garrettsworkshop/RAM2E/Documentation/Timing.png

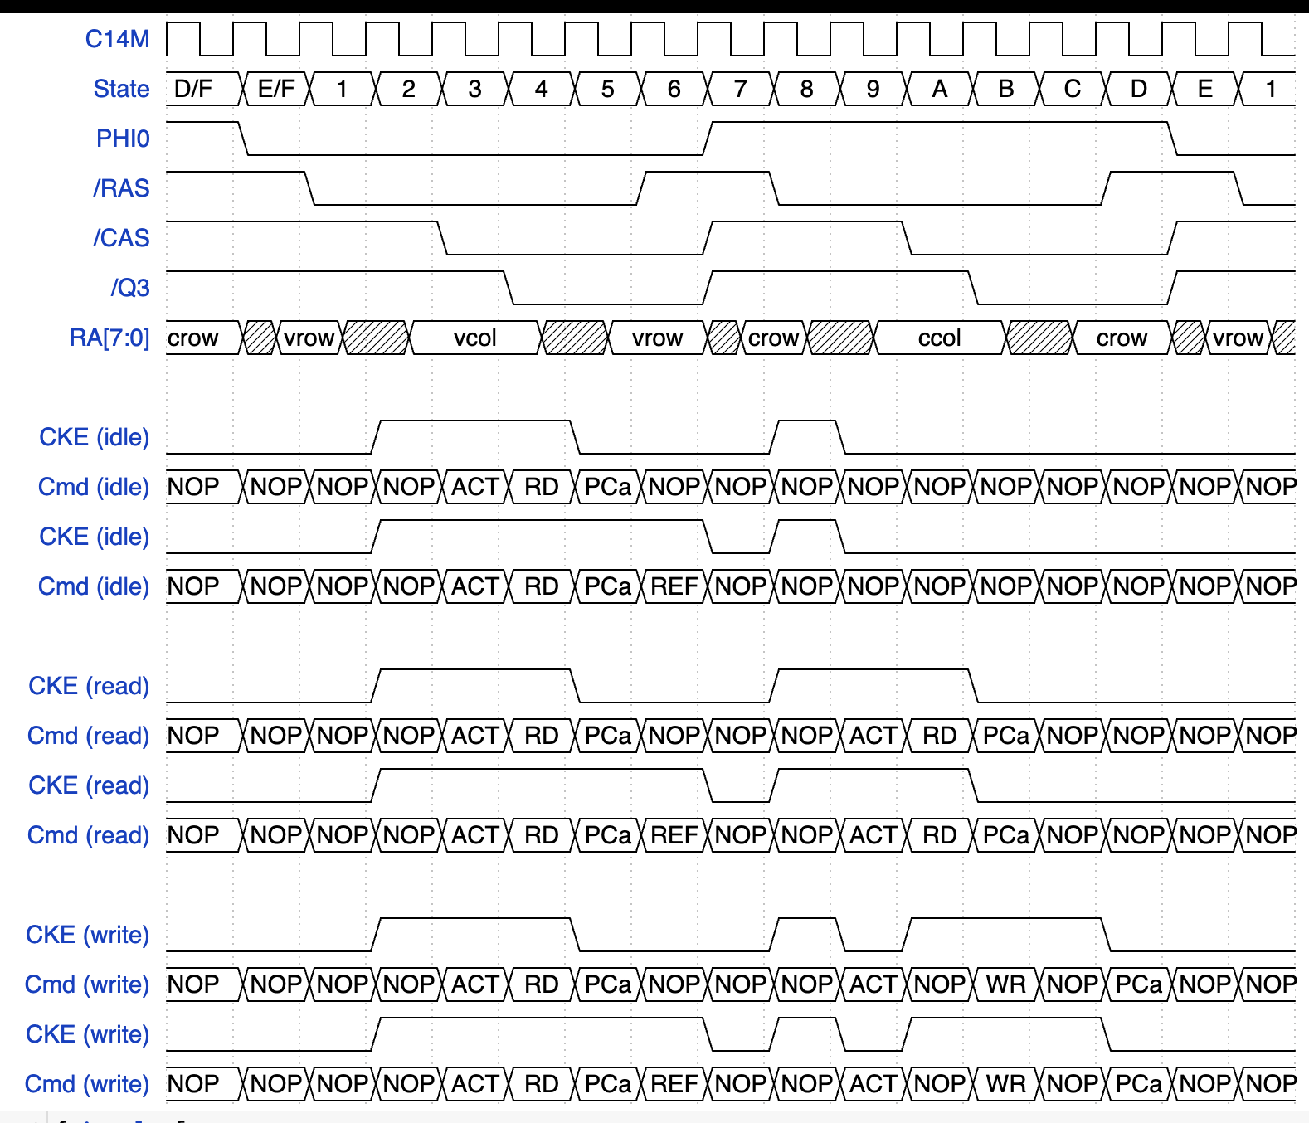
Documentation/Timing.png
