garrettsworkshop/RAM2E/Hardware/LCMXO2/Documentation/RAM2E.4203C.LCMXO2-Schematic.pdf

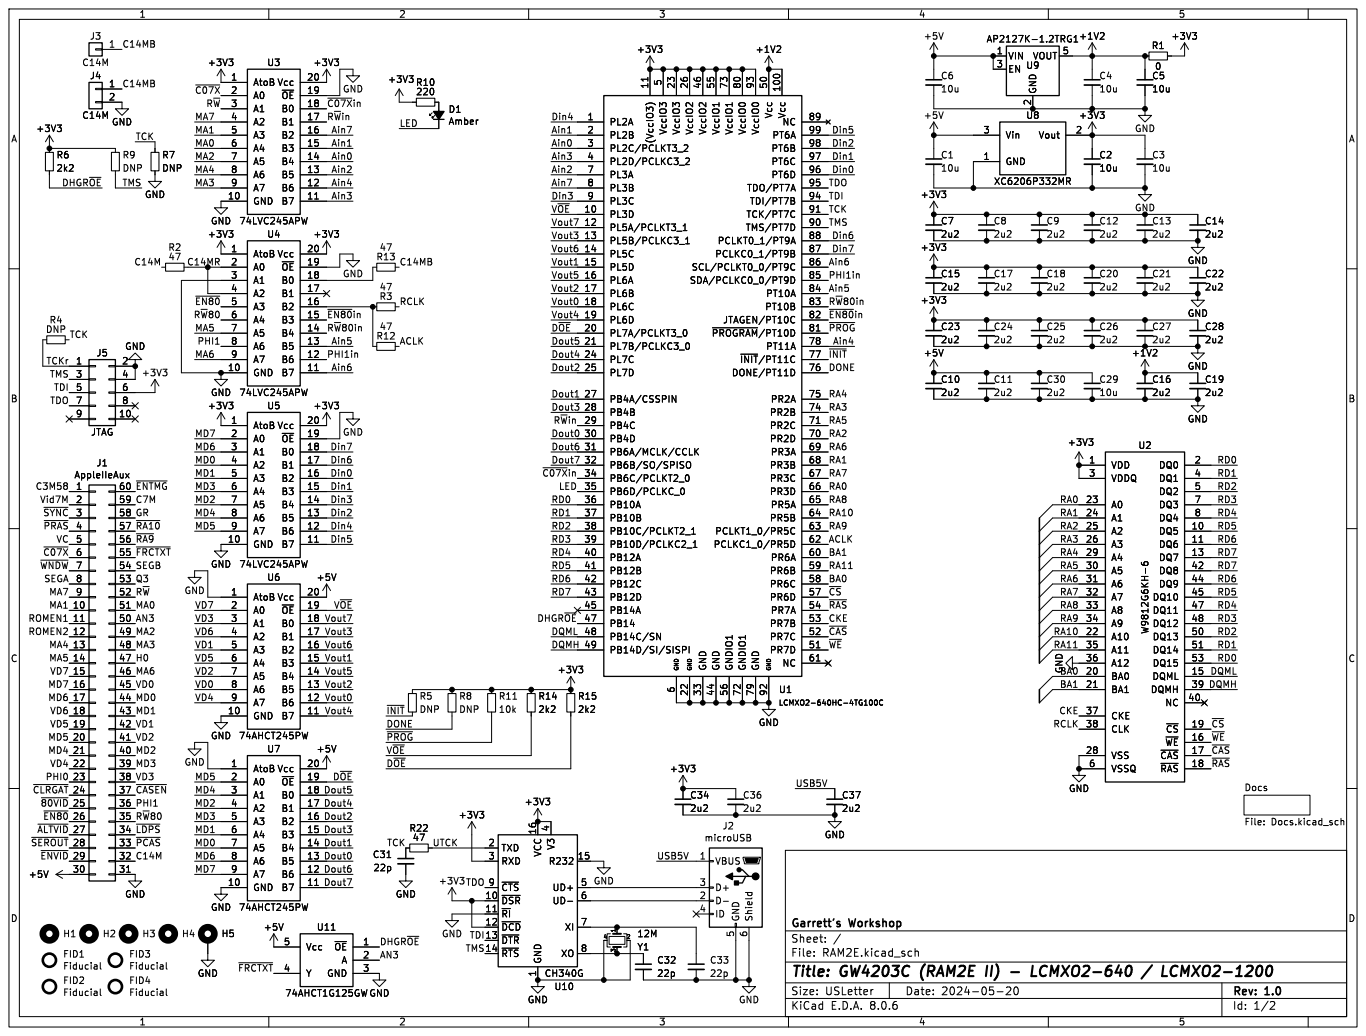
[picture p12: page 1]

2 EN 3 VOUT 5 U8 XC6206P332MR GND 1 Vout 2 Vin 3 C7

5 Vcc 50 PR7D 51 PR7C 52 PR7B 53 PR7A 54 VccIO1 55 GNDIO1 56 PR6D 57 PR6C 58 PR6B 59 GND 6 PR6A 60 NC 61 PCLKC1_0/PR5D 62 PCLKT1_0/PR5C 63 PR5B 64 PR5A 65 PR3D 66 PR3C 67 PR3B 68 PR3A 69 PL3A 7 PR2D 70 PR2C 71 GNDIO1 72 VccIO1 73 PR2B 74 PR2A 75 DONE/PT11D 76 ~{INIT}/PT11C 77 PT11A 78 GND 79 PL3B 8 VccIO0 80

4 UD+ 5 UD- 6 XI 7 XO 8 ~{CTS} 9 GND GND

1 ~{DSR} 10 ~{RI} 11 ~{DCD} 12 ~{DTR} 13 ~{RTS} 14 R232 VCC 15 16 TXD 2 RXD 3 V3

4 UD+ 5 UD- 6 XI 7 XO 8 ~{CTS} 9 U10 CH340G

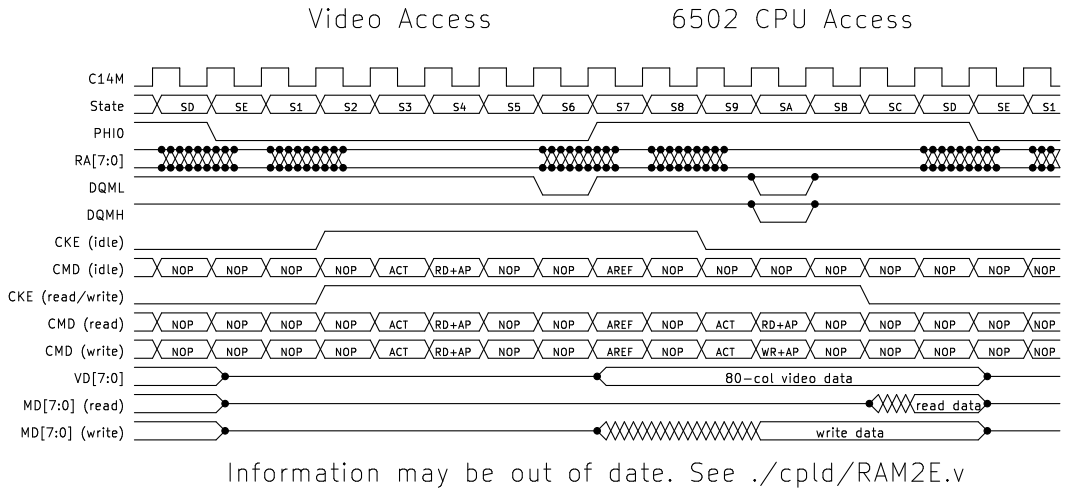
[picture p13: page 2]

ACT NOP NOP NOP

File: Docs.kicad_sch Sheet: /Docs/ Garrett's Workshop
