garrettsworkshop/RAM2E/Hardware/MAX/Documentation/RAM2E.4203C.MAX-Schematic.pdf

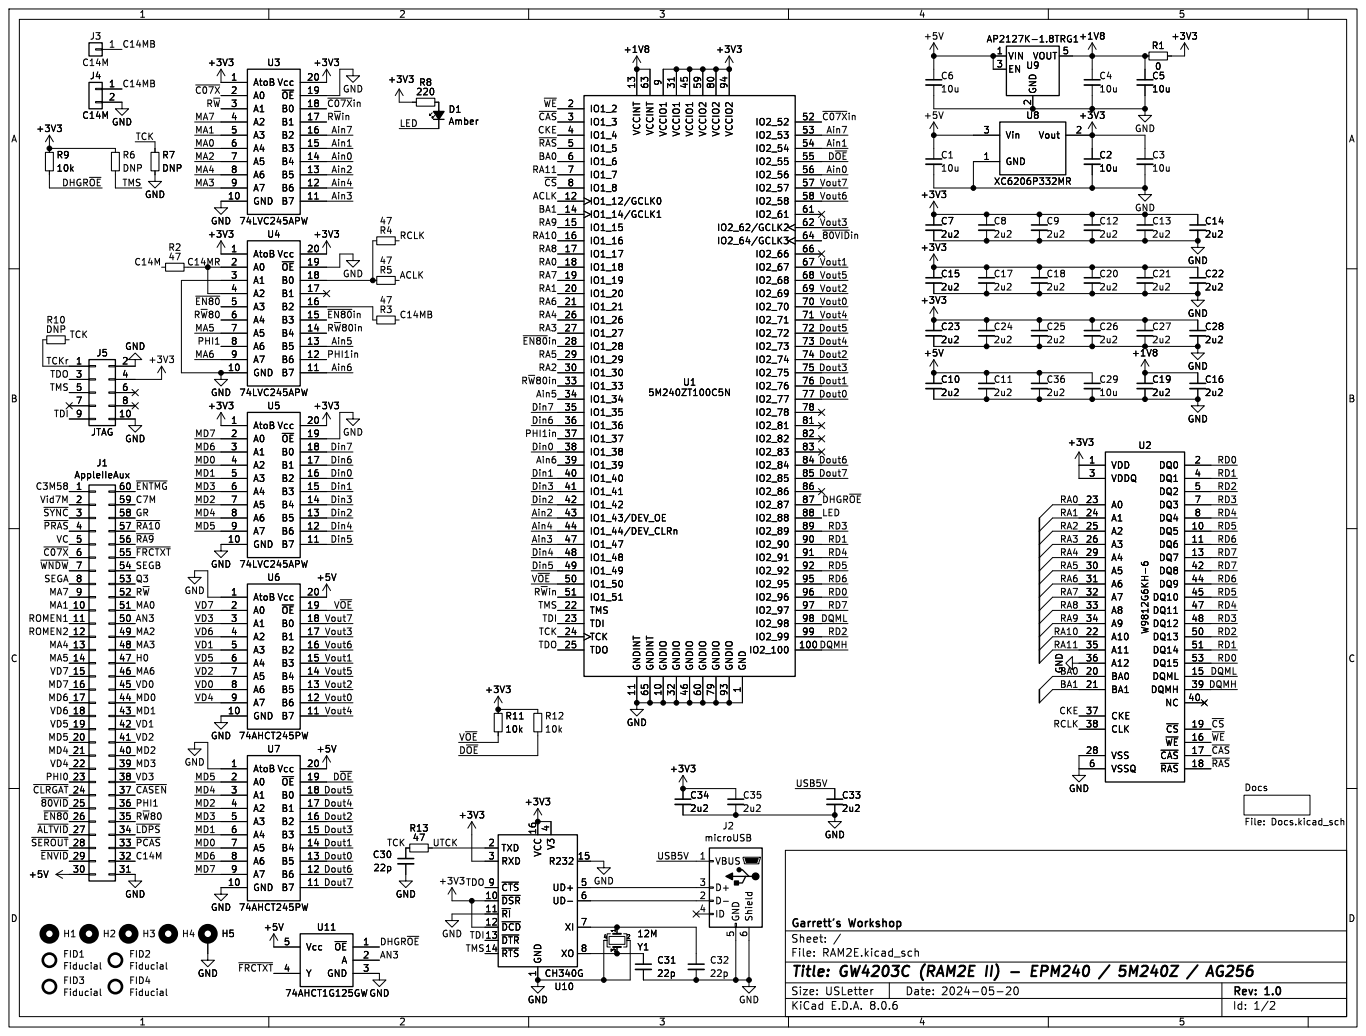
[picture p14: page 1]

2 EN 3 VOUT 5 U8 XC6206P332MR GND 1 Vout 2 Vin 3 +3V3 C22

V~{OE} TMS Din5 ~{EN80}in PHI1in Din5 V~{OE}

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

4 UD+ 5 UD- 6 XI 7 XO 8 ~{CTS} 9 U10 CH340G

4 UD+ 5 UD- 6 XI 7 XO 8 ~{CTS} 9 GND


ACT ACT NOP CKE (idle) DQML RA[7:0] DQMH

File: Docs.kicad_sch Sheet: /Docs/ Garrett's Workshop
