garrettsworkshop/RAM2E/Hardware/LCMXO2/Documentation/RAM2E.4203C.LCMXO2-Placement.pdf

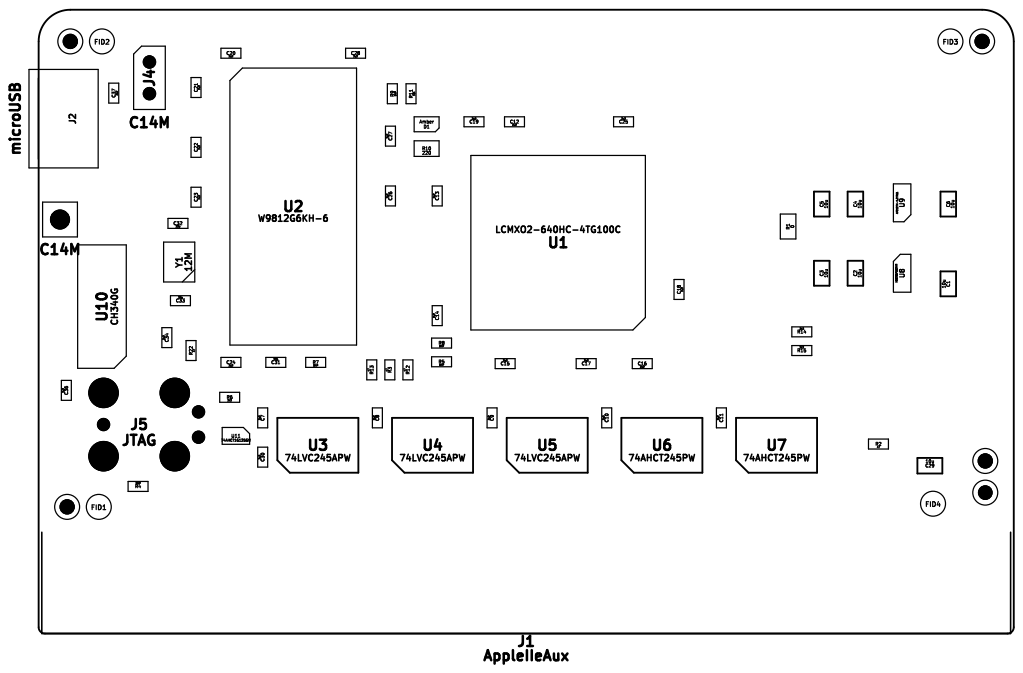
[picture p15: page 1]
