garrettsworkshop/RAM2E/Hardware/MAX/Documentation/RAM2E.4203C.MAX-Placement.pdf

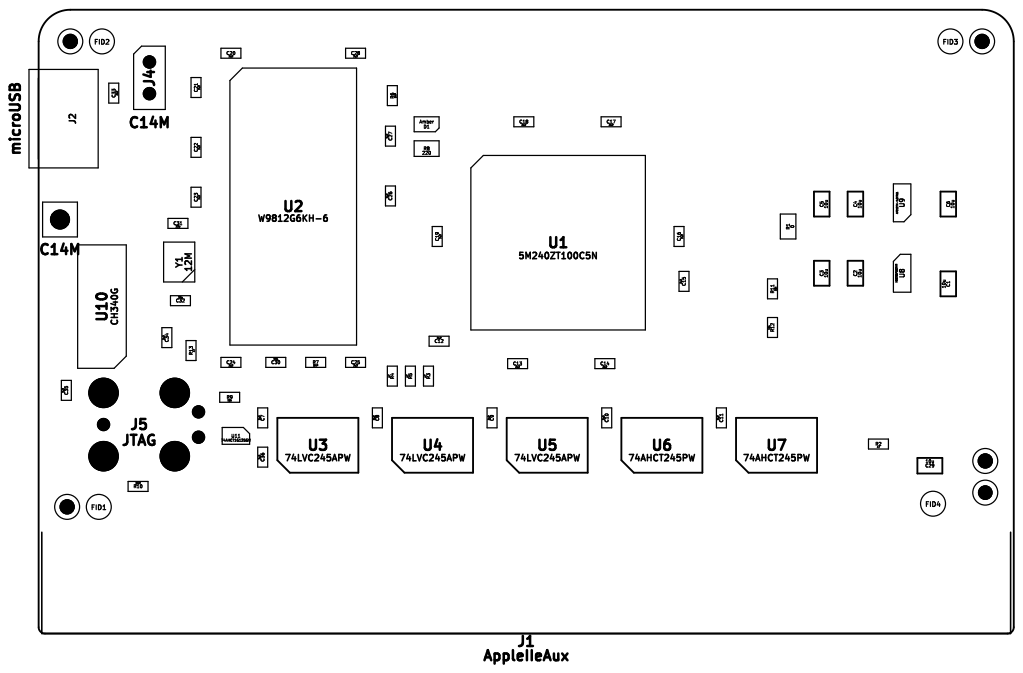
[picture p16: page 1]
