garrettsworkshop/RAM2E/Hardware/LCMXO2/RAM2E.kicad_pcb

## KiCad design Hardware/LCMXO2/RAM2E.kicad_pcb (2025-02-15)

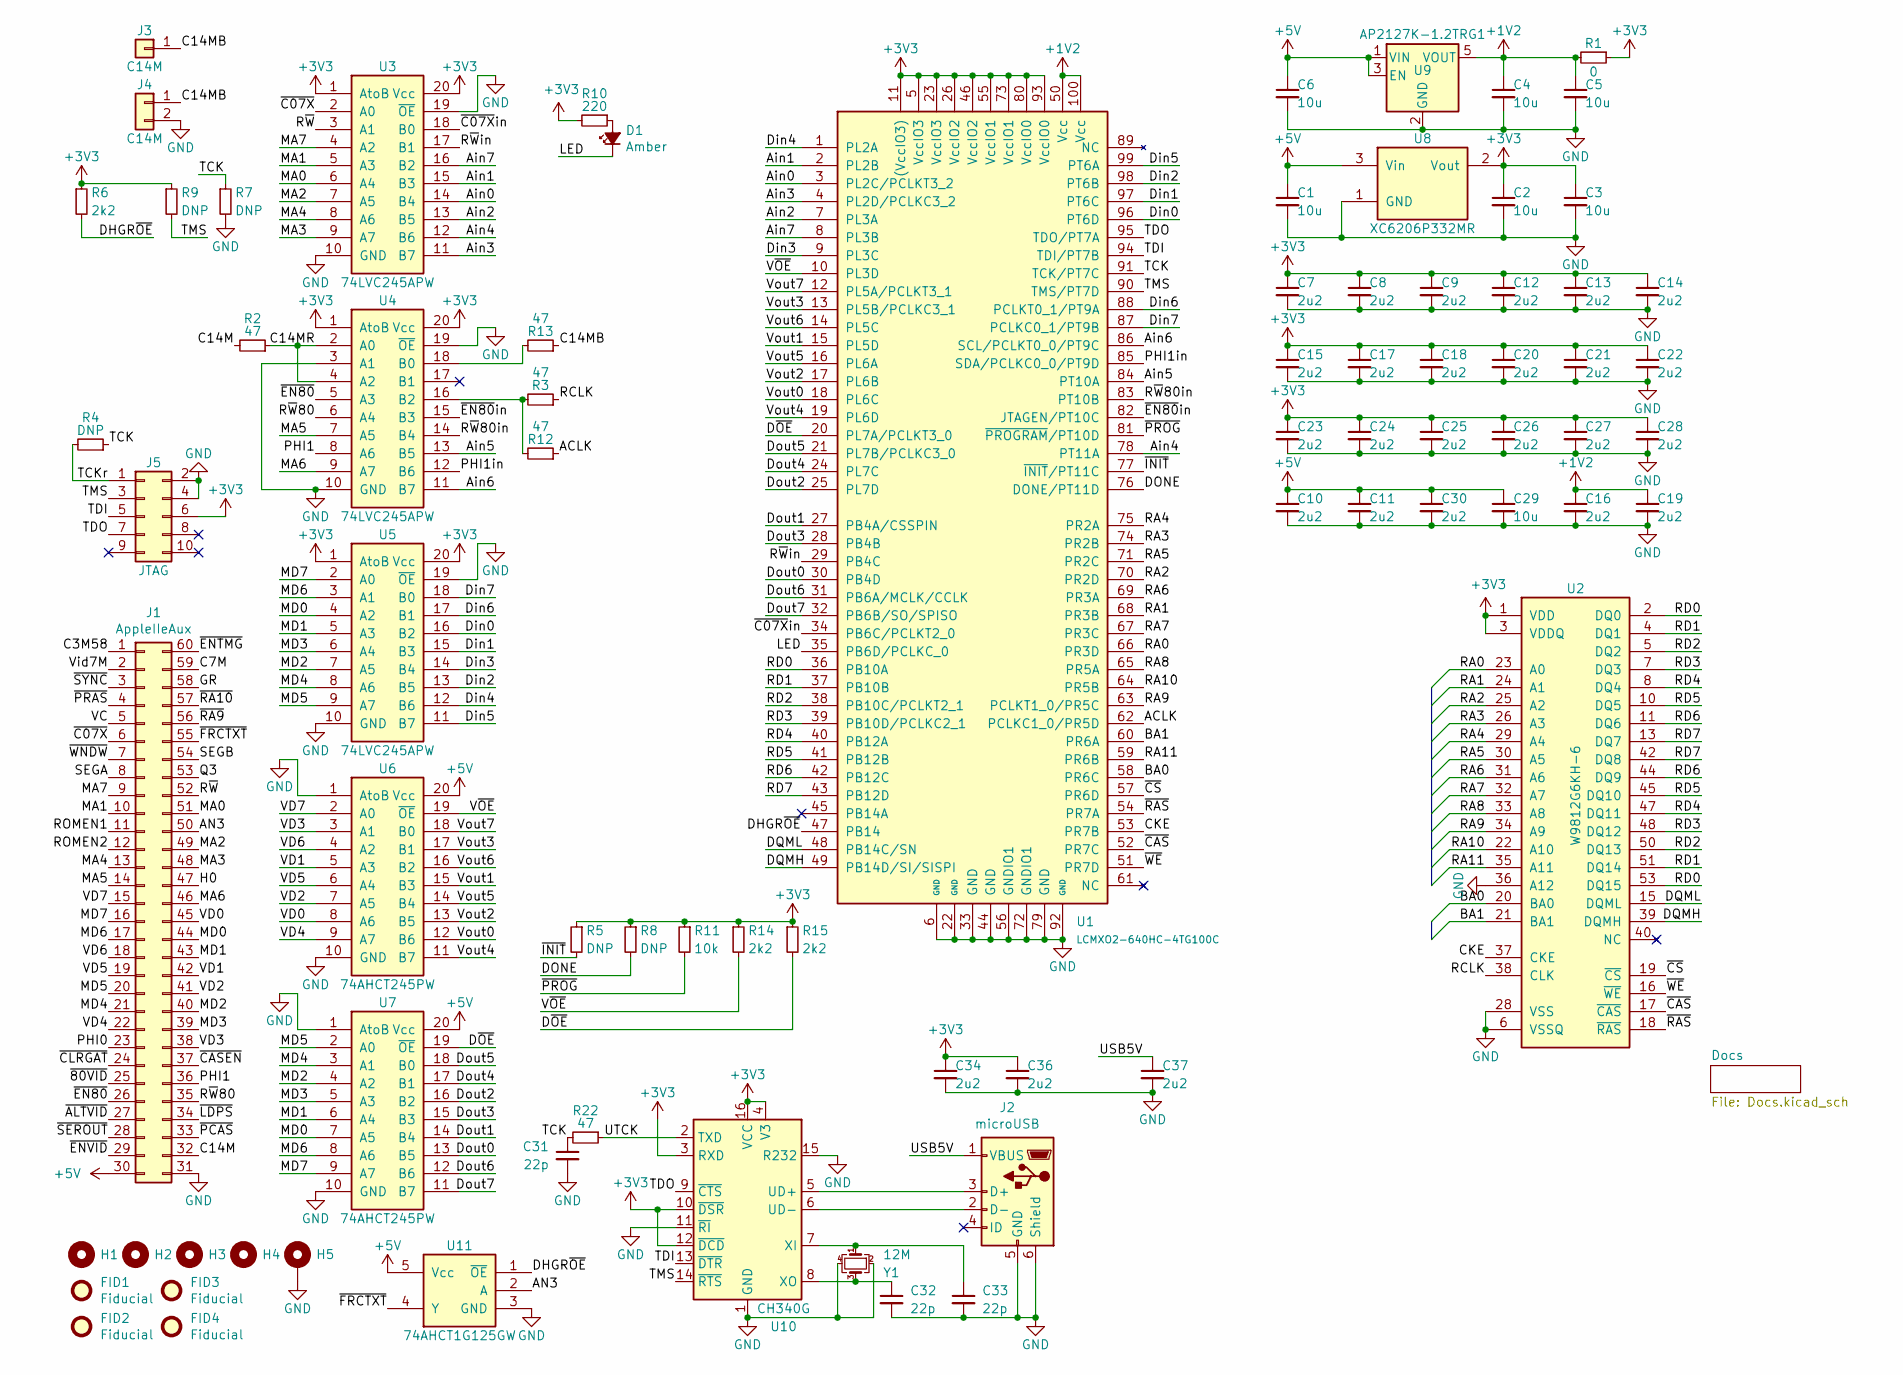
[picture p17: schematic RAM2E.kicad_sch, GW4203C (RAM2E II) - LCMXO2-640 / LCMXO2-1200]

Parts:
C1, C2, C3, C4, C5, C6, C29: 10u; C_0805; LCSC Part C15850
C7, C8, C9, C10, C11, C12, C13, C14, C15, C16, C17, C18, C19, C20, C21, C22, C23, C24, C25, C26, C27, C28, C30, C34, C36, C37: 2u2; C_0603; LCSC Part C23630
C31, C32, C33: 22p; C_0603; LCSC Part C1653
D1: Amber; LED_0805; LCSC Part C284932
FID1, FID2, FID3, FID4: Fiducial
H1, H2, H3, H4: PasteHole_1.152mm_NPTH
H5: PasteHole_1.1mm_PTH
J1: AppleIIeAux; AppleIIeAux_Edge
J2: microUSB; USB_Micro-B_Amphenol_10118192-0001; LCSC Part C132564
J3: C14M; EdgeClipHole
J4: C14M; PinHeader_1x02_P2.54mm_Vertical
J5: JTAG; Tag-Connect_TC2050-IDC-FP_2x05_P1.27mm_Vertical
R1: 0; R_0805; LCSC Part C17477
R2, R3, R12, R13, R22: 47; R_0603; LCSC Part C23182
R4, R5, R7, R8, R9: DNP; R_0603
R6, R14, R15: 2k2; R_0603; LCSC Part C4190
R10: 220; R_0805; LCSC Part C17557
R11: 10k; R_0603; LCSC Part C25804
U1: LCMXO2-640HC-4TG100C; TQFP-100_14x14mm_P0.5mm; LCSC Part C1519051
U2: W9812G6KH-6; TSOP-II-54_22.2x10.16mm_P0.8mm; LCSC Part C62379
U3, U4, U5: 74LVC245APW; TSSOP-20_4.4x6.5mm_P0.65mm; LCSC Part C6082
U6, U7: 74AHCT245PW; TSSOP-20_4.4x6.5mm_P0.65mm; LCSC Part C173388
U8: XC6206P332MR; SOT-23; LCSC Part C5446
U9: AP2127K-1.2TRG1; SOT-23-5; LCSC Part C151376
U10: CH340G; SOIC-16_3.9mm; LCSC Part C14267
U11: 74AHCT1G125GW; SOT-353; LCSC Part C12495
Y1: 12M; Crystal_SMD_3225-4Pin_3.2x2.5mm; LCSC Part C9002

Connections:
+1V2: C4.1, C5.1, C16.1, C19.1, R1.2, U1.50 (Vcc), U1.100 (Vcc), U9.5 (VOUT)
+3V3: C2.1, C3.1, C7.1, C8.1, C9.1, C12.1, C13.1, C14.1, C15.1, C17.1, C18.1, C20.1, C21.1, C22.1, C23.1, C24.1, C25.1, C26.1, C27.1, C28.1, C34.1, C36.1, J5.6, R1.1, R5.1, R6.1, R8.1, R9.1, R10.2, R11.1, R14.1, R15.1, U1.5 (VccIO3), U1.11 ((VccIO3)), U1.23 (VccIO3), U1.26 (VccIO2), U1.46 (VccIO2), U1.55 (VccIO1), U1.73 (VccIO1), U1.80 (VccIO0), U1.93 (VccIO0), U2.1 (VDD), U2.3 (VDDQ), U2.9 (VDDQ), U2.14 (VDD), U2.27 (VDD), U2.43 (VDDQ), U2.49 (VDDQ), U3.1 (AtoB), U3.20 (Vcc), U4.1 (AtoB), U4.20 (Vcc), U5.1 (AtoB), U5.20 (Vcc), U8.2 (Vout), U10.3 (RXD), U10.4 (V3), U10.10 (~DSR), U10.12 (~DCD), U10.16 (VCC)
+5V: C1.1, C6.1, C10.1, C11.1, C29.1, C30.1, J1.30, U6.20 (Vcc), U7.20 (Vcc), U8.3 (Vin), U9.1 (VIN), U9.3 (EN), U11.5 (Vcc)
/ACLK: R12.1, U1.62 (PCLKC1_0/PR5D)
/AN3: J1.50, U11.2 (A)
/Ain0: U1.3 (PL2C/PCLKT3_2), U3.14 (B4)
/Ain1: U1.2 (PL2B), U3.15 (B3)
/Ain2: U1.7 (PL3A), U3.13 (B5)
/Ain3: U1.4 (PL2D/PCLKC3_2), U3.11 (B7)
/Ain4: U1.78 (PT11A), U3.12 (B6)
/Ain5: U1.84 (PT10A), U4.13 (B5)
/Ain6: U1.86 (SCL/PCLKT0_0/PT9C), U4.11 (B7)
/Ain7: U1.8 (PL3B), U3.16 (B2)
/BA0: U1.58 (PR6C), U2.20 (BA0)
/BA1: U1.60 (PR6A), U2.21 (BA1)
/C3M58: J1.1
/C7M: J1.59
/C14M: J1.32, R2.2
/C14MB: J3.1, J4.1, R13.1
/C14MR: R2.1, U4.2 (A0), U4.4 (A2)
/CKE: U1.53 (PR7B), U2.37 (CKE)
/DHGR~OE: R6.2, U1.47 (PB14), U11.1 (~OE)
/DONE: R8.2, U1.76 (DONE/PT11D)
/DQMH: U1.49 (PB14D/SI/SISPI), U2.39 (DQMH)
/DQML: U1.48 (PB14C/SN), U2.15 (DQML)
/Din0: U1.96 (PT6D), U5.16 (B2)
/Din1: U1.97 (PT6C), U5.15 (B3)
/Din2: U1.98 (PT6B), U5.13 (B5)
/Din3: U1.9 (PL3C), U5.14 (B4)
/Din4: U1.1 (PL2A), U5.12 (B6)
/Din5: U1.99 (PT6A), U5.11 (B7)
/Din6: U1.88 (PCLKT0_1/PT9A), U5.17 (B1)
/Din7: U1.87 (PCLKC0_1/PT9B), U5.18 (B0)
/Dout0: U1.30 (PB4D), U7.13 (B5)
/Dout1: U1.27 (PB4A/CSSPIN), U7.14 (B4)
/Dout2: U1.25 (PL7D), U7.16 (B2)
/Dout3: U1.28 (PB4B), U7.15 (B3)
/Dout4: U1.24 (PL7C), U7.17 (B1)
/Dout5: U1.21 (PL7B/PCLKC3_0), U7.18 (B0)
/Dout6: U1.31 (PB6A/MCLK/CCLK), U7.12 (B6)
/Dout7: U1.32 (PB6B/SO/SPISO), U7.11 (B7)
/D~OE: R15.2, U1.20 (PL7A/PCLKT3_0), U7.19 (~OE)
/GR: J1.58
/H0: J1.47
/LED: D1.1 (K), U1.35 (PB6D/PCLKC_0)
/MA0: J1.51, U3.6 (A4)
/MA1: J1.10, U3.5 (A3)
/MA2: J1.49, U3.7 (A5)
/MA3: J1.48, U3.9 (A7)
/MA4: J1.13, U3.8 (A6)
/MA5: J1.14, U4.7 (A5)
/MA6: J1.46, U4.9 (A7)
/MA7: J1.9, U3.4 (A2)
/MD0: J1.44, U5.4 (A2), U7.7 (A5)
/MD1: J1.43, U5.5 (A3), U7.6 (A4)
/MD2: J1.40, U5.7 (A5), U7.4 (A2)
/MD3: J1.39, U5.6 (A4), U7.5 (A3)
/MD4: J1.21, U5.8 (A6), U7.3 (A1)
/MD5: J1.20, U5.9 (A7), U7.2 (A0)
/MD6: J1.17, U5.3 (A1), U7.8 (A6)
/MD7: J1.16, U5.2 (A0), U7.9 (A7)
/PHI0: J1.23
/PHI1: J1.36, U4.8 (A6)
/PHI1in: U1.85 (SDA/PCLKC0_0/PT9D), U4.12 (B6)
/Q3: J1.53
/RA0: U1.66 (PR3D), U2.23 (A0)
/RA1: U1.68 (PR3B), U2.24 (A1)
/RA2: U1.70 (PR2D), U2.25 (A2)
/RA3: U1.74 (PR2B), U2.26 (A3)
/RA4: U1.75 (PR2A), U2.29 (A4)
/RA5: U1.71 (PR2C), U2.30 (A5)
/RA6: U1.69 (PR3A), U2.31 (A6)
/RA7: U1.67 (PR3C), U2.32 (A7)
/RA8: U1.65 (PR5A), U2.33 (A8)
/RA9: U1.63 (PCLKT1_0/PR5C), U2.34 (A9)
/RA10: U1.64 (PR5B), U2.22 (A10)
/RA11: U1.59 (PR6B), U2.35 (A11)
/RCLK: R3.1, U2.38 (CLK)
/RD0: U1.36 (PB10A), U2.2 (DQ0), U2.53 (DQ15)
/RD1: U1.37 (PB10B), U2.4 (DQ1), U2.51 (DQ14)
/RD2: U1.38 (PB10C/PCLKT2_1), U2.5 (DQ2), U2.50 (DQ13)
/RD3: U1.39 (PB10D/PCLKC2_1), U2.7 (DQ3), U2.48 (DQ12)
/RD4: U1.40 (PB12A), U2.8 (DQ4), U2.47 (DQ11)
/RD5: U1.41 (PB12B), U2.10 (DQ5), U2.45 (DQ10)
/RD6: U1.42 (PB12C), U2.11 (DQ6), U2.44 (DQ9)
/RD7: U1.43 (PB12D), U2.13 (DQ7), U2.42 (DQ8)
/ROMEN1: J1.11
/ROMEN2: J1.12
/R~W: J1.52, U3.3 (A1)
/R~W80: J1.35, U4.6 (A4)
/R~W80in: U1.83 (PT10B), U4.14 (B4)
/R~Win: U1.29 (PB4C), U3.17 (B1)
/SEGA: J1.8
/SEGB: J1.54
/TCK: C31.1, R4.1, R7.1, R22.2, U1.91 (TCK/PT7C)
/TCKr: J5.1, R4.2
/TDI: J5.5, U1.94 (TDI/PT7B), U10.13 (~DTR)
/TDO: J5.7, U1.95 (TDO/PT7A), U10.9 (~CTS)
/TMS: J5.3, R9.2, U1.90 (TMS/PT7D), U10.14 (~RTS)
/USB5V: C37.1, J2.1 (VBUS)
/UTCK: R22.1, U10.2 (TXD)
/VC: J1.5
/VD0: J1.45, U6.8 (A6)
/VD1: J1.42, U6.5 (A3)
/VD2: J1.41, U6.7 (A5)
/VD3: J1.38, U6.3 (A1)
/VD4: J1.22, U6.9 (A7)
/VD5: J1.19, U6.6 (A4)
/VD6: J1.18, U6.4 (A2)
/VD7: J1.15, U6.2 (A0)
/Vid7M: J1.2
/Vout0: U1.18 (PL6C), U6.12 (B6)
/Vout1: U1.15 (PL5D), U6.15 (B3)
/Vout2: U1.17 (PL6B), U6.13 (B5)
/Vout3: U1.13 (PL5B/PCLKC3_1), U6.17 (B1)
/Vout4: U1.19 (PL6D), U6.11 (B7)
/Vout5: U1.16 (PL6A), U6.14 (B4)
/Vout6: U1.14 (PL5C), U6.16 (B2)
/Vout7: U1.12 (PL5A/PCLKT3_1), U6.18 (B0)
/V~OE: R14.2, U1.10 (PL3D), U6.19 (~OE)
/~80VID: J1.25
/~ALTVID: J1.27
/~C07X: J1.6, U3.2 (A0)
/~C07Xin: U1.34 (PB6C/PCLKT2_0), U3.18 (B0)
/~CASEN: J1.37
/~CAS: U1.52 (PR7C), U2.17 (~CAS)
/~CLRGAT: J1.24
/~CS: U1.57 (PR6D), U2.19 (~CS)
/~EN80: J1.26, U4.5 (A3)
/~EN80in: U1.82 (JTAGEN/PT10C), U4.15 (B3)
/~ENTMG: J1.60
/~ENVID: J1.29
/~FRCTXT: J1.55, U11.4 (Y)
/~INIT: R5.2, U1.77 (~INIT/PT11C)
/~LDPS: J1.34
/~PCAS: J1.33
/~PRAS: J1.4
/~PROG: R11.2, U1.81 (~PROGRAM/PT10D)
/~RA9: J1.56
/~RA10: J1.57
/~RAS: U1.54 (PR7A), U2.18 (~RAS)
/~SEROUT: J1.28
/~SYNC: J1.3
/~WE: U1.51 (PR7D), U2.16 (~WE)
/~WNDW: J1.7
GND: C1.2, C2.2, C3.2, C4.2, C5.2, C6.2, C7.2, C8.2, C9.2, C10.2, C11.2, C12.2, C13.2, C14.2, C15.2, C16.2, C17.2, C18.2, C19.2, C20.2, C21.2, C22.2, C23.2, C24.2, C25.2, C26.2, C27.2, C28.2, C29.2, C30.2, C31.2, C32.2, C33.2, C34.2, C36.2, C37.2, H5.1, J1.31, J2.5 (GND), J2.6 (Shield), J4.2, J5.2, J5.4, R7.2, U1.6 (GND), U1.22 (GND), U1.33 (GND), U1.44 (GND), U1.56 (GNDIO1), U1.72 (GNDIO1), U1.79 (GND), U1.92 (GND), U2.6 (VSSQ), U2.12 (VSSQ), U2.28 (VSS), U2.36 (A12), U2.41 (VSS), U2.46 (VSSQ), U2.52 (VSSQ), U2.54 (VSS), U3.10 (GND), U3.19 (~OE), U4.3 (A1), U4.10 (GND), U4.19 (~OE), U5.10 (GND), U5.19 (~OE), U6.1 (AtoB), U6.10 (GND), U7.1 (AtoB), U7.10 (GND), U8.1 (GND), U9.2 (GND), U10.1 (GND), U10.11 (~RI), U10.15 (R232), U11.3 (GND), Y1.2, Y1.4
unnamed: D1.2 (A), R10.1
unnamed: J2.3 (D+), U10.5 (UD+)
unnamed: J2.2 (D-), U10.6 (UD-)
unnamed: R13.2, U4.18 (B0)
unnamed: R3.2, R12.2, U4.16 (B2)
unnamed: C33.1, U10.7 (XI), Y1.1
unnamed: C32.1, U10.8 (XO), Y1.3

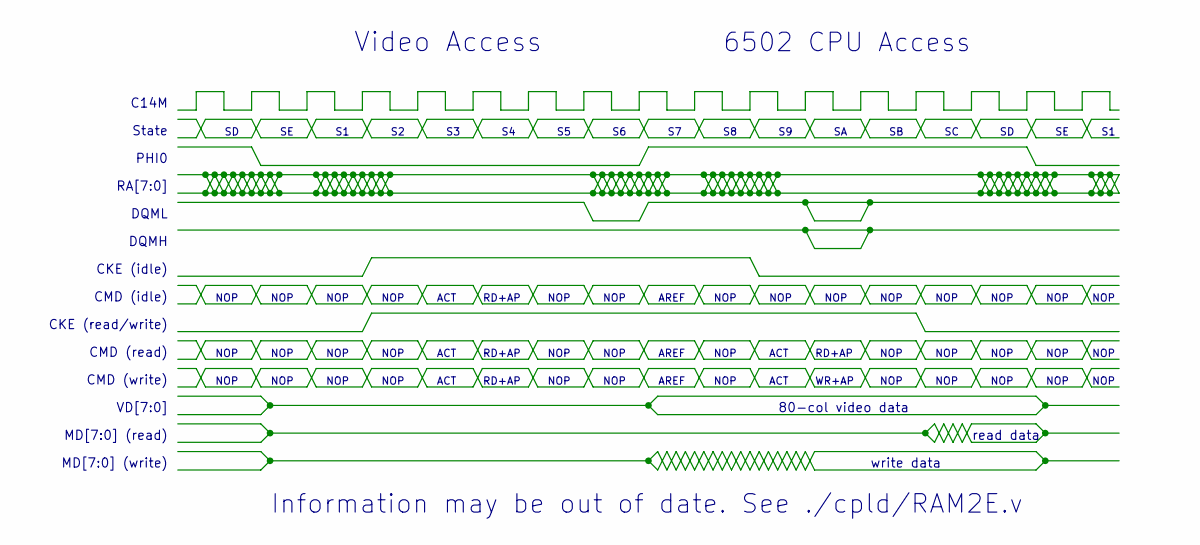
[picture p18: schematic Docs.kicad_sch, GW4203C (RAM2E II) - LCMXO2-640 / LCMXO2-1200]

Notes on the sheet:
NOP
Video Access
MD[7:0] (read)
CMD (idle)
MD[7:0] (write)
ACT
DQML
CMD (read)
Information may be out of date. See ./cpld/RAM2E.v
CKE (read/write)
AREF
VD[7:0]
80-col video data
RD+AP
CKE (idle)
State
write data
C14M
6502 CPU Access
DQMH
WR+AP
PHI0
RA[7:0]
read data
CMD (write)

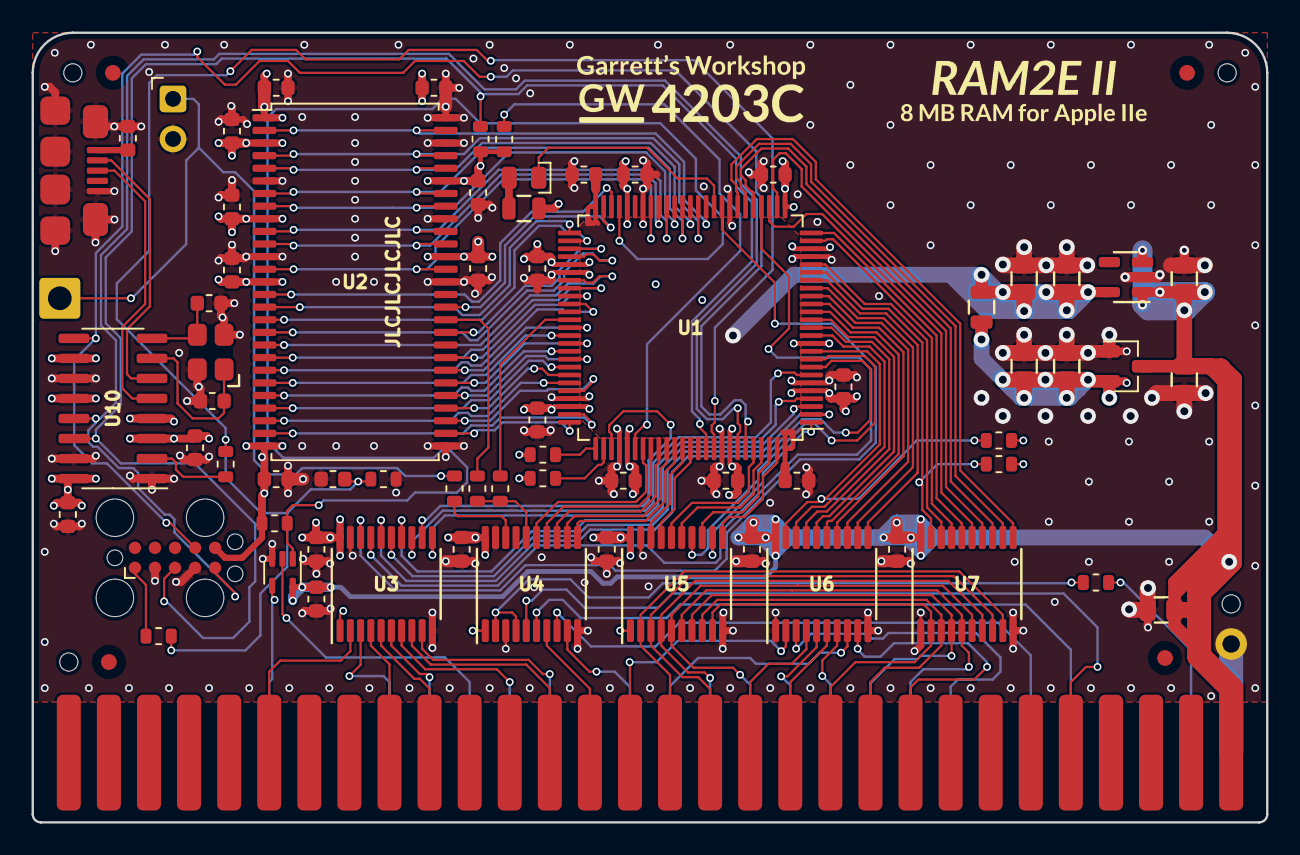
[picture p19: board RAM2E.kicad_pcb from above]

Board: 4 copper layers, 78.2 x 50.0 mm, 79 parts (0 on the bottom side), 127 nets.
