garrettsworkshop/RAM2E/(commit log)

2020-07-25 Add GW4203B files
    [Docs.sch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]
2020-08-02 Documentation update
    [Docs.sch, RAM2E.kicad_pcb, RAM2E.sch]
2020-08-05 As submitted to JLCPCB August 2020
    [Docs.sch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]
2020-08-08 August 2020 JLCPCB again
    [RAM2E-BOM.csv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]
2020-08-21 As submitted to JLCPCB August 21 2020
    [RAM2E-B_Cu.gbl, RAM2E-B_Mask.gbs, RAM2E-B_SilkS.gbo, RAM2E-Edge_Cuts.gm1, RAM2E-F_Cu.gtl, RAM2E-F_Mask.gts, RAM2E-F_Paste.gtp, RAM2E-F_SilkS.gto]
2020-09-10 Updated schematic with 1V8 regulator and MAX V
    [RAM2E.kicad_pcb, RAM2E.sch]
2020-09-16 Improve power consumption
    Gated RAM access during PHI0, squeezed video access and MPU access together, gated data bus output buffer OE to only output at end of PHI0
2020-09-17 Fix snow on screen
    Previous commit had "snow" in 80-col mode when updating display. Put back command timing to fix problem. Kept PHI0 read gating depending on EN80 and data output gating
    [RAM2E.v]
2020-09-25 Update timing diagram in schematic
    Now reflects longer MAX V propagation delays
    [Docs.sch]
2020-09-29 Fabbed 9/29/2020
    [RAM2E-BOM.csv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]
2020-10-09 Actually fabbed 10/6/2020
    [Docs.sch, RAM2E-BOM.csv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]
2020-12-16 Added C14M buffering and header
    [RAM2E.kicad_pcb, RAM2E.sch]
2021-01-28 Gitignore Quartus CDFs (chain definition files)
2021-02-16 Add MAX V BOM and placement table
    [RAM2E-BOM-MAXV.csv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]
2021-05-22 still workin
    [RAM2E.kicad_pcb, RAM2E.sch]
2021-06-01 Generated gerbers and documentation
    [Docs.sch, RAM2E-BOM-MAXV.csv, RAM2E-BOM.LCMXO2.csv, RAM2E-BOM.MAX.csv, RAM2E-BOM.csv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]
2021-06-01 Fixed DRC violations on LCMXO2 and iCE40 boards
    [RAM2E-B_Cu.gbl, RAM2E-B_Mask.gbs, RAM2E-B_SilkS.gbo, RAM2E-Edge_Cuts.gm1, RAM2E-F_Cu.gtl, RAM2E-F_Mask.gts, RAM2E-F_Paste.gtp, RAM2E-F_SilkS.gto]
2021-06-01 DNP 3d models and add FrontIsom render pics of all board variants
    [RAM2E.kicad_pcb]
2021-06-01 BOM finished
    [RAM2E-BOM.AGM.csv, RAM2E-BOM.LCMXO2.csv, RAM2E-BOM.LCMXO2HC.csv, RAM2E-BOM.LCMXO2HE.csv, RAM2E-BOM.LCMXO2ZE.csv, RAM2E-BOM.MAX.csv, RAM2E-BOM.MAXII.csv, RAM2E-BOM.MAXIIG.csv]
2023-09-21 Fixed MachXO board wrong JTAG pinout
    [Docs.kicad_sch, RAM2E.kicad_pcb, RAM2E.kicad_sch, RAM2E.sch]
2023-11-11 Fixed LED and current-limiting resistor values in BOM
    [RAM2E-BOM.LCMXO2HC.csv, RAM2E-BOM.LCMXO2HE.csv, RAM2E-BOM.MAXII.csv, RAM2E-BOM.MAXV.csv]
2023-11-21 As sent to testers
    [Docs.kicad_sch]
2023-12-18 Revert "As sent to testers"
    This reverts commit 4249ebe98332ad6fb679362fa153720a3e50f79b.
    [Docs.kicad_sch]
2024-01-31 Change BOM to separate U4 from U3 and U5
    [RAM2E-BOM.LCMXO2HC.csv, RAM2E-BOM.LCMXO2HE.csv, RAM2E-BOM.MAXII.csv, RAM2E-BOM.MAXV.csv, RAM2E.kicad_pcb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]
2024-02-08 Small board revision, still v2.0
    [RAM2E-B_Cu.gbl, RAM2E-B_Mask.gbs, RAM2E-B_Silkscreen.gbo, RAM2E-Edge_Cuts.gm1, RAM2E-F_Cu.gtl, RAM2E-F_Mask.gts, RAM2E-F_Paste.gtp, RAM2E-F_Silkscreen.gto]
2024-04-16 Update Makefile to add BOM generation
2024-04-24 RC 2.1
    [Docs.kicad_sch, RAM2E-BOM.csv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]
2024-04-24 Remove C14M header 3d model
    [RAM2E.kicad_pcb]
2024-04-24 RC
    Fix board IDs
    [RAM2E-B_Cu.gbl, RAM2E-B_Mask.gbs, RAM2E-B_Silkscreen.gbo, RAM2E-Edge_Cuts.gm1, RAM2E-F_Cu.gtl, RAM2E-F_Mask.gts, RAM2E-F_Paste.gtp, RAM2E-F_Silkscreen.gto]
2025-02-15 RC C.1.1
    [Docs.kicad_sch, RAM2E-BOM.csv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]
